davisjp1822/Quince_2560i/README.md

# Quince_2560i
Digital Input Protection Board with Ethernet for the Arduino Mega 2560

More information (and board available for purchase) at [https://www.three-ml.com](https://www.three-ml.com)
