davisjp1822/Quince_2560i/arduino-mega-io-protection.kicad_pcb

## KiCad design arduino-mega-io-protection.kicad_pcb (2017-09-17)

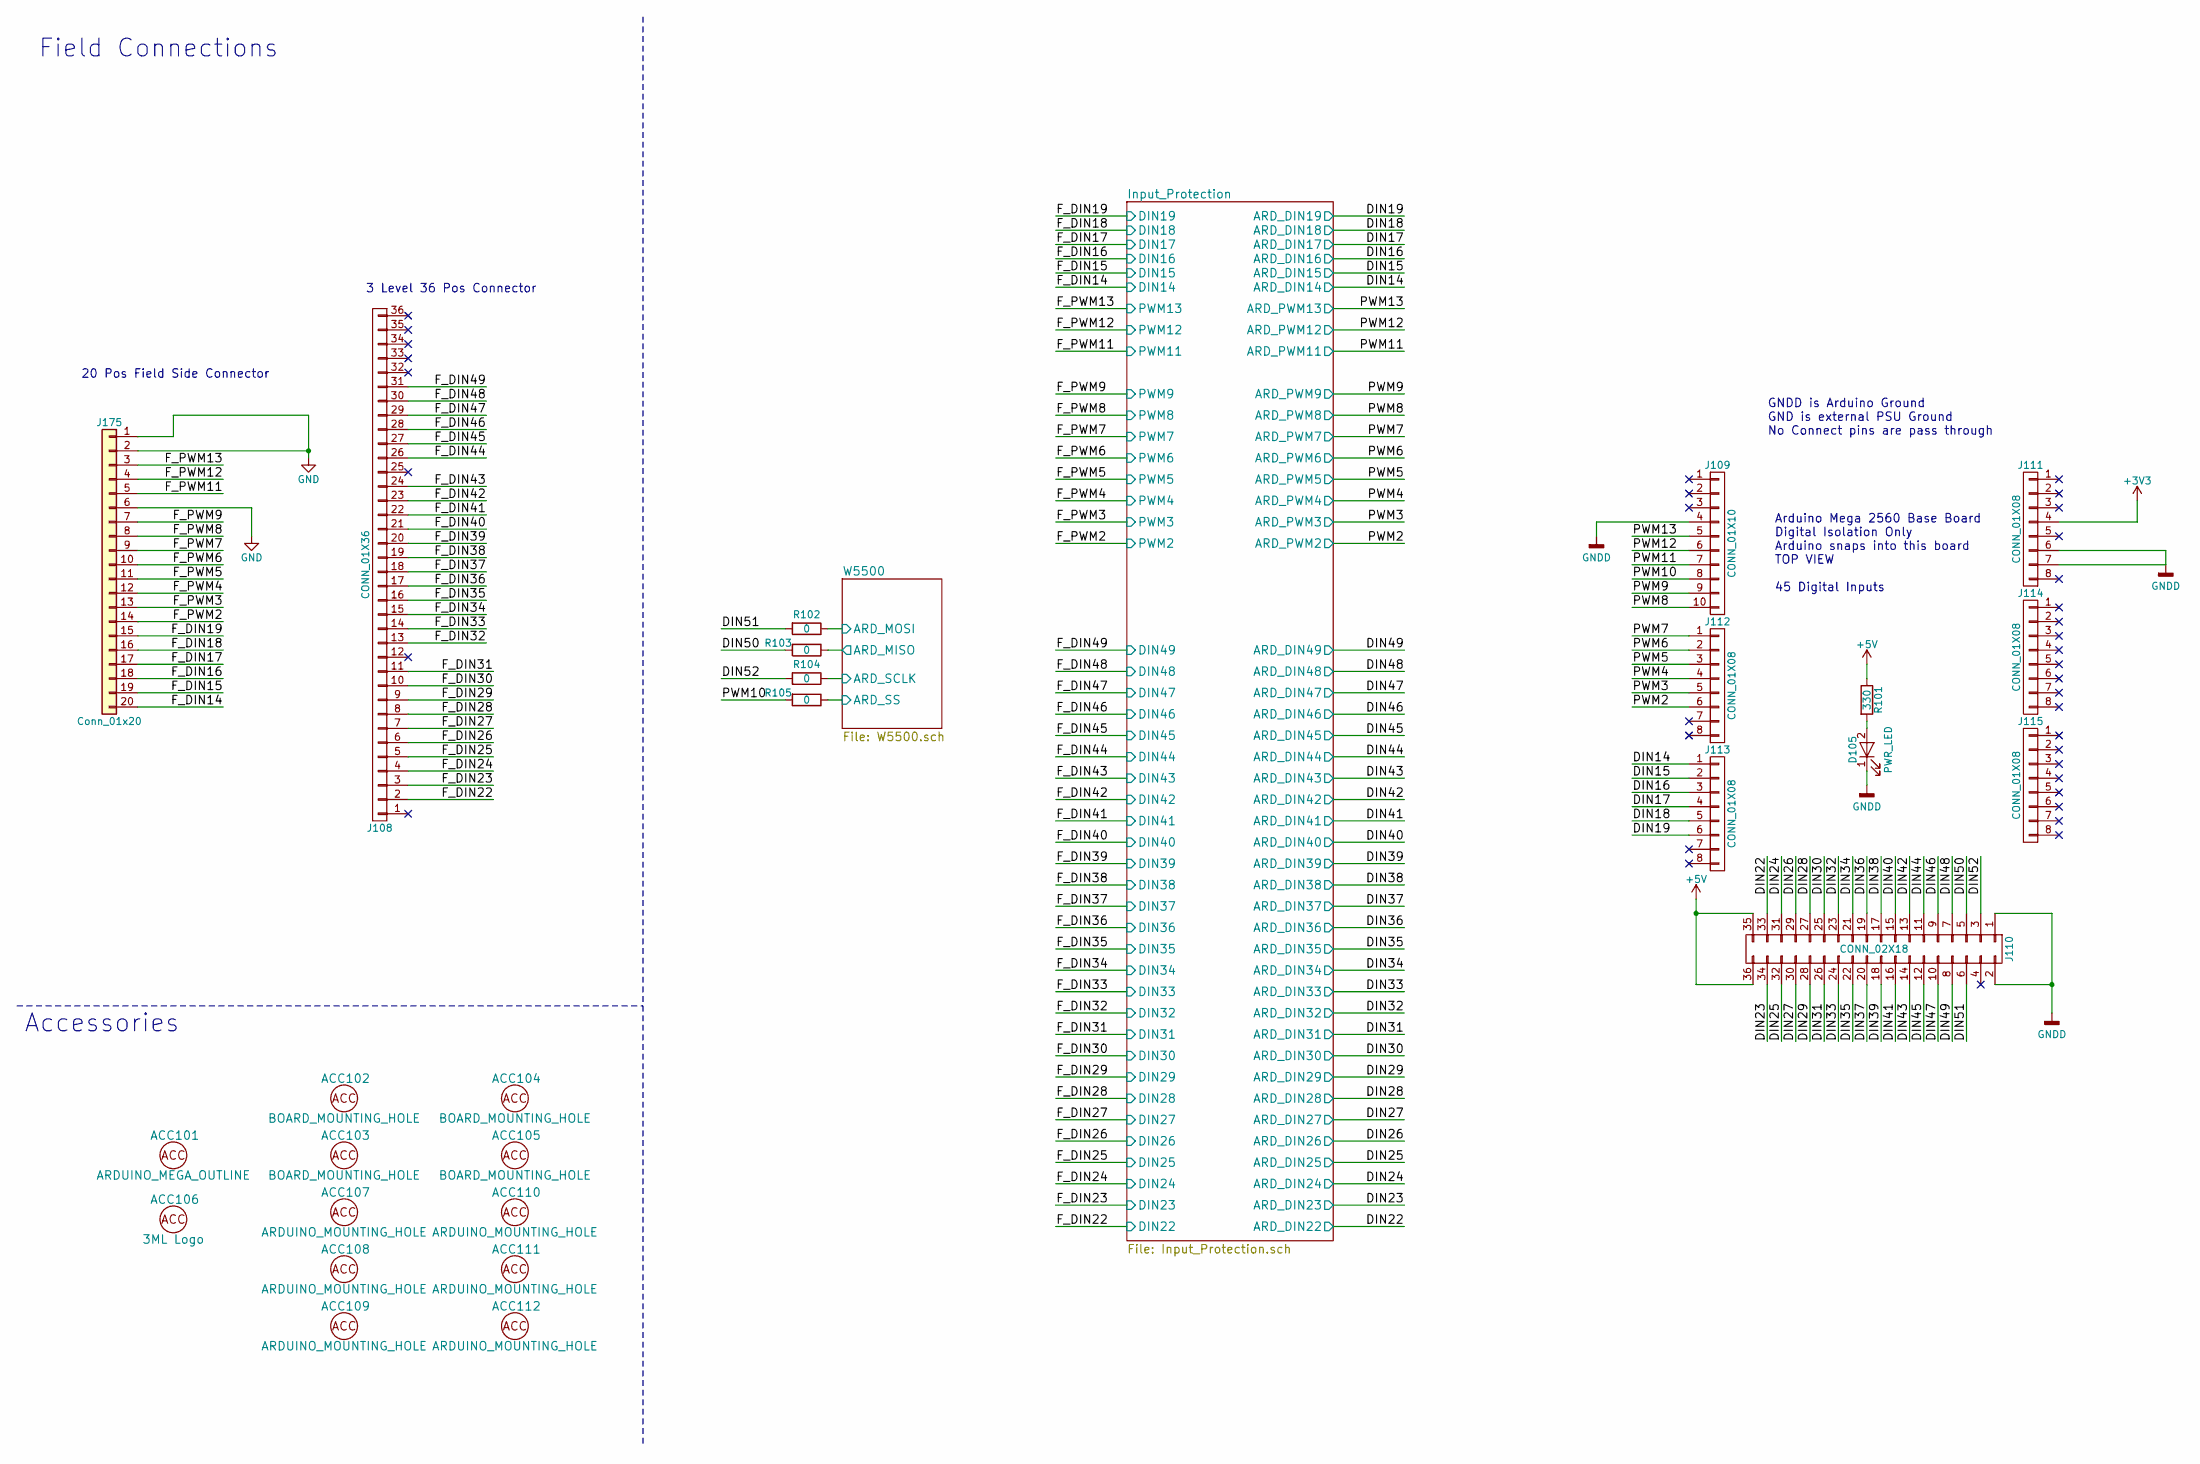
[picture p1: schematic arduino-mega-io-protection.sch, Quince 2560i Input Module with Ethernet]

Parts:
ACC101: ARDUINO_MEGA_OUTLINE; Arduino_Mega_2560__UPSIDE_DOWN_Footprint; MPN Value
ACC102, ACC103, ACC104, ACC105: BOARD_MOUNTING_HOLE; MountingHole_3.2mm_M3; MPN Value
ACC106: 3ML Logo; 3ML_LOGO; MPN X
ACC107, ACC108, ACC109, ACC110, ACC111, ACC112: ARDUINO_MOUNTING_HOLE; MountingHole_3.2mm_M3; MPN Value
D105: PWR_LED; LED_1206; MPN PG1101W-TR
J108: CONN_01X36; Phoenix_1727832; MPN 1727832
J109: CONN_01X10; Pin_Header_Straight_1x10_Pitch2.54mm; MPN X
J110: CONN_02X18; Pin_Header_Straight_2x18_Pitch2.54mm; MPN X
J111, J112, J113, J114, J115: CONN_01X08; Pin_Header_Straight_1x08_Pitch2.54mm; MPN X
J175: Conn_01x20; Phoenix-1x20-1709678
R101: 330; R_0805; MPN ERJ-P06J331V
R102, R103, R104, R105: 0; R_0805; MPN RC0805JR-070RL

Connections:
+3V3: J111.4; also elsewhere on the board
+5V: J110.35, J110.36, R101.1; also elsewhere on the board
/DIN14: J113.1; also elsewhere on the board
/DIN15: J113.2; also elsewhere on the board
/DIN16: J113.3; also elsewhere on the board
/DIN17: J113.4; also elsewhere on the board
/DIN18: J113.5; also elsewhere on the board
/DIN19: J113.6; also elsewhere on the board
/DIN22: J110.33; also elsewhere on the board
/DIN23: J110.34; also elsewhere on the board
/DIN24: J110.31; also elsewhere on the board
/DIN25: J110.32; also elsewhere on the board
/DIN26: J110.29; also elsewhere on the board
/DIN27: J110.30; also elsewhere on the board
/DIN28: J110.27; also elsewhere on the board
/DIN29: J110.28; also elsewhere on the board
/DIN30: J110.25; also elsewhere on the board
/DIN31: J110.26; also elsewhere on the board
/DIN32: J110.23; also elsewhere on the board
/DIN33: J110.24; also elsewhere on the board
/DIN34: J110.21; also elsewhere on the board
/DIN35: J110.22; also elsewhere on the board
/DIN36: J110.19; also elsewhere on the board
/DIN37: J110.20; also elsewhere on the board
/DIN38: J110.17; also elsewhere on the board
/DIN39: J110.18; also elsewhere on the board
/DIN40: J110.15; also elsewhere on the board
/DIN41: J110.16; also elsewhere on the board
/DIN42: J110.13; also elsewhere on the board
/DIN43: J110.14; also elsewhere on the board
/DIN44: J110.11; also elsewhere on the board
/DIN45: J110.12; also elsewhere on the board
/DIN46: J110.9; also elsewhere on the board
/DIN47: J110.10; also elsewhere on the board
/DIN48: J110.7; also elsewhere on the board
/DIN49: J110.8; also elsewhere on the board
/DIN50: J110.5, R103.2
/DIN51: J110.6, R102.2
/DIN52: J110.3, R104.2
/F_DIN14: J175.20; also elsewhere on the board
/F_DIN15: J175.19; also elsewhere on the board
/F_DIN16: J175.18; also elsewhere on the board
/F_DIN17: J175.17; also elsewhere on the board
/F_DIN18: J175.16; also elsewhere on the board
/F_DIN19: J175.15; also elsewhere on the board
/F_DIN22: J108.2; also elsewhere on the board
/F_DIN23: J108.3; also elsewhere on the board
/F_DIN24: J108.4; also elsewhere on the board
/F_DIN25: J108.5; also elsewhere on the board
/F_DIN26: J108.6; also elsewhere on the board
/F_DIN27: J108.7; also elsewhere on the board
/F_DIN28: J108.8; also elsewhere on the board
/F_DIN29: J108.9; also elsewhere on the board
/F_DIN30: J108.10; also elsewhere on the board
/F_DIN31: J108.11; also elsewhere on the board
/F_DIN32: J108.13; also elsewhere on the board
/F_DIN33: J108.14; also elsewhere on the board
/F_DIN34: J108.15; also elsewhere on the board
/F_DIN35: J108.16; also elsewhere on the board
/F_DIN36: J108.17; also elsewhere on the board
/F_DIN37: J108.18; also elsewhere on the board
/F_DIN38: J108.19; also elsewhere on the board
/F_DIN39: J108.20; also elsewhere on the board
/F_DIN40: J108.21; also elsewhere on the board
/F_DIN41: J108.22; also elsewhere on the board
/F_DIN42: J108.23; also elsewhere on the board
/F_DIN43: J108.24; also elsewhere on the board
/F_DIN44: J108.26; also elsewhere on the board
/F_DIN45: J108.27; also elsewhere on the board
/F_DIN46: J108.28; also elsewhere on the board
/F_DIN47: J108.29; also elsewhere on the board
/F_DIN48: J108.30; also elsewhere on the board
/F_DIN49: J108.31; also elsewhere on the board
/F_PWM2: J175.14; also elsewhere on the board
/F_PWM3: J175.13; also elsewhere on the board
/F_PWM4: J175.12; also elsewhere on the board
/F_PWM5: J175.11; also elsewhere on the board
/F_PWM6: J175.10; also elsewhere on the board
/F_PWM7: J175.9; also elsewhere on the board
/F_PWM8: J175.8; also elsewhere on the board
/F_PWM9: J175.7; also elsewhere on the board
/F_PWM11: J175.5; also elsewhere on the board
/F_PWM12: J175.4; also elsewhere on the board
/F_PWM13: J175.3; also elsewhere on the board
/PWM2: J112.6; also elsewhere on the board
/PWM3: J112.5; also elsewhere on the board
/PWM4: J112.4; also elsewhere on the board
/PWM5: J112.3; also elsewhere on the board
/PWM6: J112.2; also elsewhere on the board
/PWM7: J112.1; also elsewhere on the board
/PWM8: J109.10; also elsewhere on the board
/PWM9: J109.9; also elsewhere on the board
/PWM10: J109.8, R105.2
/PWM11: J109.7; also elsewhere on the board
/PWM12: J109.6; also elsewhere on the board
/PWM13: J109.5; also elsewhere on the board
/W5500/ARD_MISO: R103.1; also elsewhere on the board
/W5500/ARD_MOSI: R102.1; also elsewhere on the board
/W5500/ARD_SCLK: R104.1; also elsewhere on the board
/W5500/ARD_SS: R105.1; also elsewhere on the board
GND: J175.1, J175.2, J175.6; also elsewhere on the board
GNDD: D105.1 (K), J109.4, J110.1, J110.2, J111.6, J111.7; also elsewhere on the board
unnamed: D105.2 (A), R101.2

Notes on the sheet:
GNDD is Arduino Ground GND is external PSU Ground No Connect pins are pass through
Arduino Mega 2560 Base Board Digital Isolation Only Arduino snaps into this board TOP VIEW 45 Digital Inputs
3 Level 36 Pos Connector
20 Pos Field Side Connector
Accessories
Field Connections

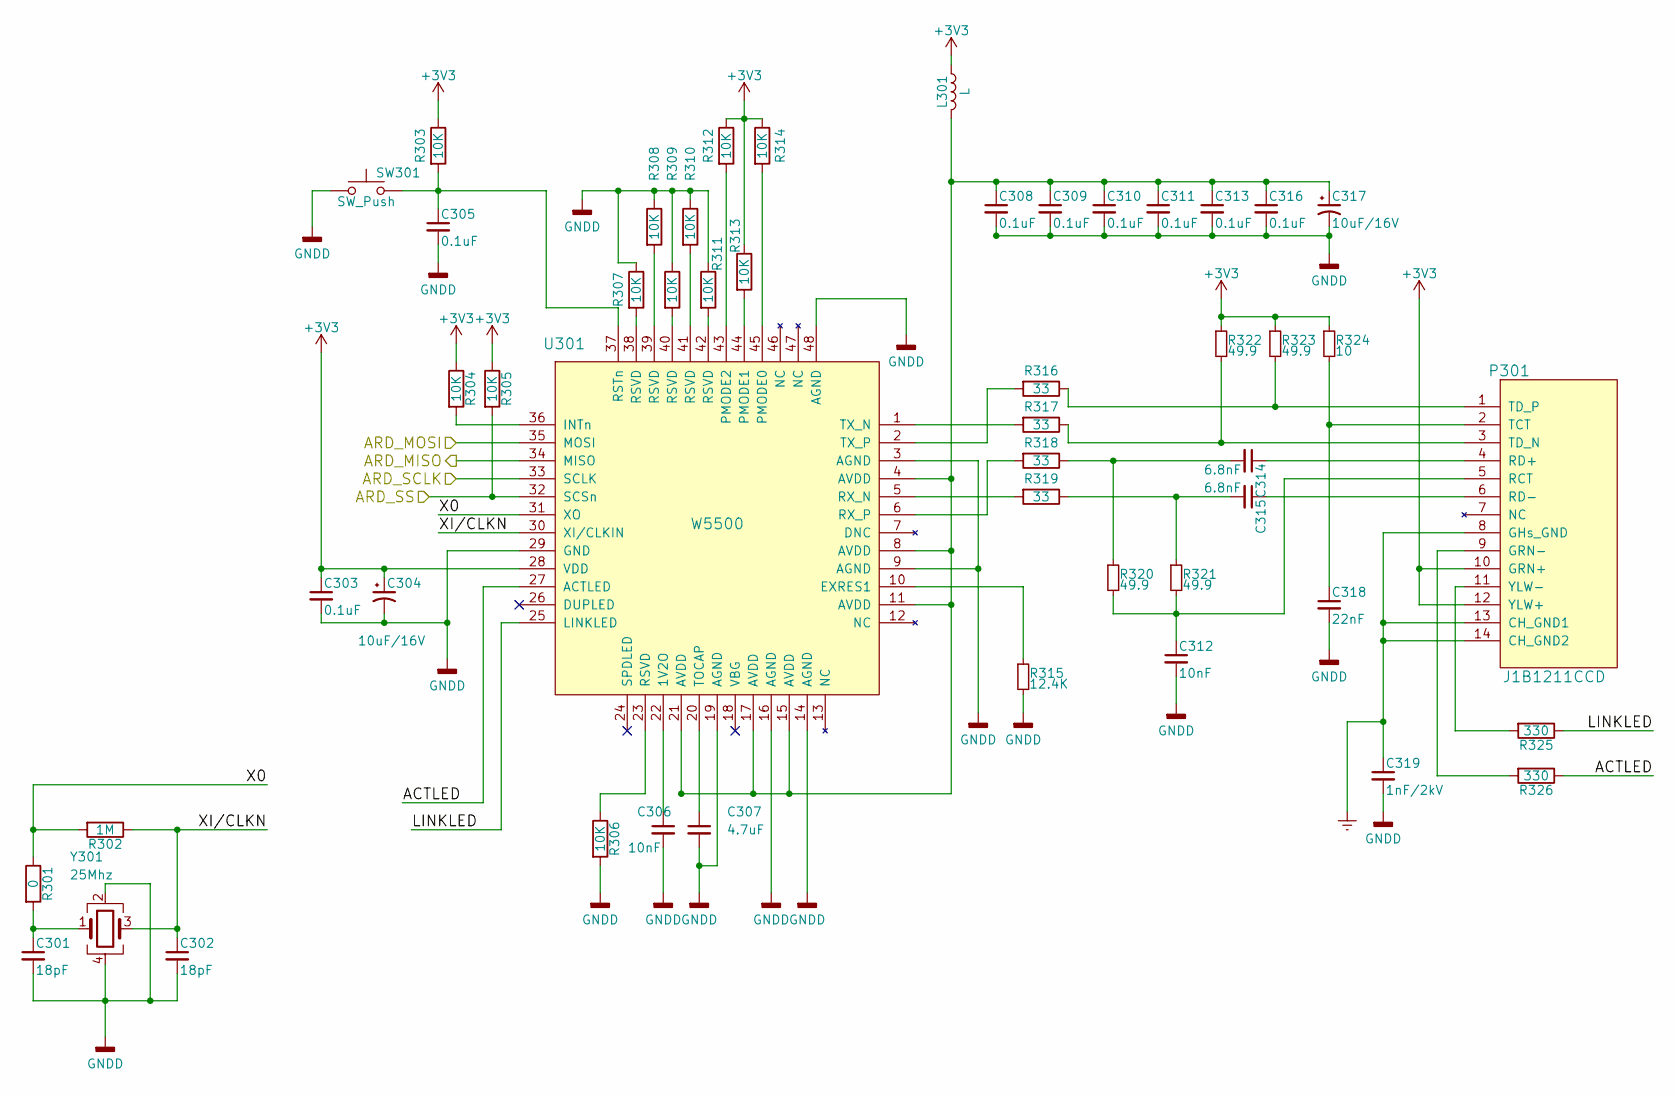
[picture p2: schematic W5500.sch, Quince 2560i W5500 Ethernet]

Parts:
C301, C302: 18pF; C_0603; MPN GRM1885C1H180FA01D
C303, C305, C308, C309, C310, C311, C313, C316: 0.1uF; C_0805; MPN 08055C104KAT2A
C304, C317: 10uF/16V; CP_Tantalum_Case-A_EIA-3216-18_Reflow; MPN F931C106MAA
C306, C312: 10nF; C_0805; MPN CC0805KRX7R9BB103
C307: 4.7uF; C_0805; MPN GRM21BR71C475KE51L
C314, C315: 6.8nF; C_0805; MPN CC0805KRX7R9BB682
C318: 22nF; C_0805; MPN C0805C223K5RACTU
C319: 1nF/2kV; C_1206; MPN 202R18W102KV4E
L301: L; R_1812; MPN 742792511
P301: J1B1211CCD; MPN J1B1211CCD
R301: 0; R_0805; MPN RC0805JR-070RL
R302: 1M; R_0805; MPN RC0805FR-071ML
R303, R304, R305, R306, R307, R308, R309, R310, R311, R312, R313, R314: 10K; R_0805; MPN RC0805JR-0710KL
R315: 12.4K; R_0805; MPN RC0805FR-0712K4L
R316, R317, R318, R319: 33; R_0805; MPN RC0805FR-0733RL
R320, R321, R322, R323: 49.9; R_0805; MPN RC0805FR-0749R9L
R324: 10; R_0805; MPN RC0805FR-0710RL
R325, R326: 330; R_0805; MPN RMCF0805JT330R
SW301: SW_Push; SW_SPST_PTS645; MPN PTS645SK43SMTR92 LFS
U301: W5500; LQFP-48_7x7mm_Pitch0.5mm; MPN W5500
Y301: 25Mhz; Oscillator_SMD_Abracon_ASE-4pin_3.2x2.5mm; MPN ABM8G-25.000MHZ-18-D2Y-T

Connections:
+3V3: C303.1, C304.1, L301.1, P301.10 (GRN+), P301.12 (YLW+), R303.1, R304.1, R305.1, R312.1, R313.1, R314.1, R322.1, R323.1, R324.1, U301.28 (VDD); also elsewhere on the board
/W5500/ACTLED: R326.1, U301.27 (ACTLED)
/W5500/ARD_MISO: U301.34 (MISO); also elsewhere on the board
/W5500/ARD_MOSI: U301.35 (MOSI); also elsewhere on the board
/W5500/ARD_SCLK: U301.33 (SCLK); also elsewhere on the board
/W5500/ARD_SS: R305.2, U301.32 (SCSn); also elsewhere on the board
/W5500/LINKLED: R325.1, U301.25 (LINKLED)
/W5500/X0: R301.1, R302.2, U301.31 (XO)
/W5500/XI/CLKN: C302.1, R302.1, U301.30 (XI/CLKIN), Y301.3
Earth: C319.1, P301.8 (GHs_GND), P301.13 (CH_GND1), P301.14 (CH_GND2)
GNDD: C301.2, C302.2, C303.2, C304.2, C305.2, C306.2, C307.2, C308.2, C309.2, C310.2, C311.2, C312.2, C313.2, C316.2, C317.2, C318.2, C319.2, R306.2, R307.1, R308.1, R309.1, R310.1, R311.1, R315.2, SW301.1, U301.3 (AGND), U301.9 (AGND), U301.14 (AGND), U301.16 (AGND), U301.19 (AGND), U301.29 (GND), U301.48 (AGND), Y301.2, Y301.4; also elsewhere on the board
unnamed: C301.1, R301.2, Y301.1
unnamed: C305.1, R303.2, SW301.2, U301.37 (RSTn)
unnamed: C306.1, U301.22 (1V2O)
unnamed: C307.1, U301.20 (TOCAP)
unnamed: C308.1, C309.1, C310.1, C311.1, C313.1, C316.1, C317.1, L301.2, U301.4 (AVDD), U301.8 (AVDD), U301.11 (AVDD), U301.15 (AVDD), U301.17 (AVDD), U301.21 (AVDD)
unnamed: C312.1, P301.5 (RCT), R320.2, R321.2
unnamed: C314.1, P301.4 (RD+)
unnamed: C314.2, R318.1, R320.1
unnamed: C315.1, P301.6 (RD-)
unnamed: C315.2, R319.1, R321.1
unnamed: C318.1, P301.2 (TCT), R324.2
unnamed: P301.1 (TD_P), R316.1, R323.2
unnamed: P301.3 (TD_N), R317.1, R322.2
unnamed: P301.9 (GRN-), R326.2
unnamed: P301.11 (YLW-), R325.2
unnamed: R304.2, U301.36 (INTn)
unnamed: R306.1, U301.23 (RSVD)
unnamed: R307.2, U301.38 (RSVD)
unnamed: R308.2, U301.39 (RSVD)
unnamed: R309.2, U301.40 (RSVD)
unnamed: R310.2, U301.41 (RSVD)
unnamed: R311.2, U301.42 (RSVD)
unnamed: R312.2, U301.43 (PMODE2)
unnamed: R313.2, U301.44 (PMODE1)
unnamed: R314.2, U301.45 (PMODE0)
unnamed: R315.1, U301.10 (EXRES1)
unnamed: R316.2, U301.2 (TX_P)
unnamed: R317.2, U301.1 (TX_N)
unnamed: R318.2, U301.6 (RX_P)
unnamed: R319.2, U301.5 (RX_N)

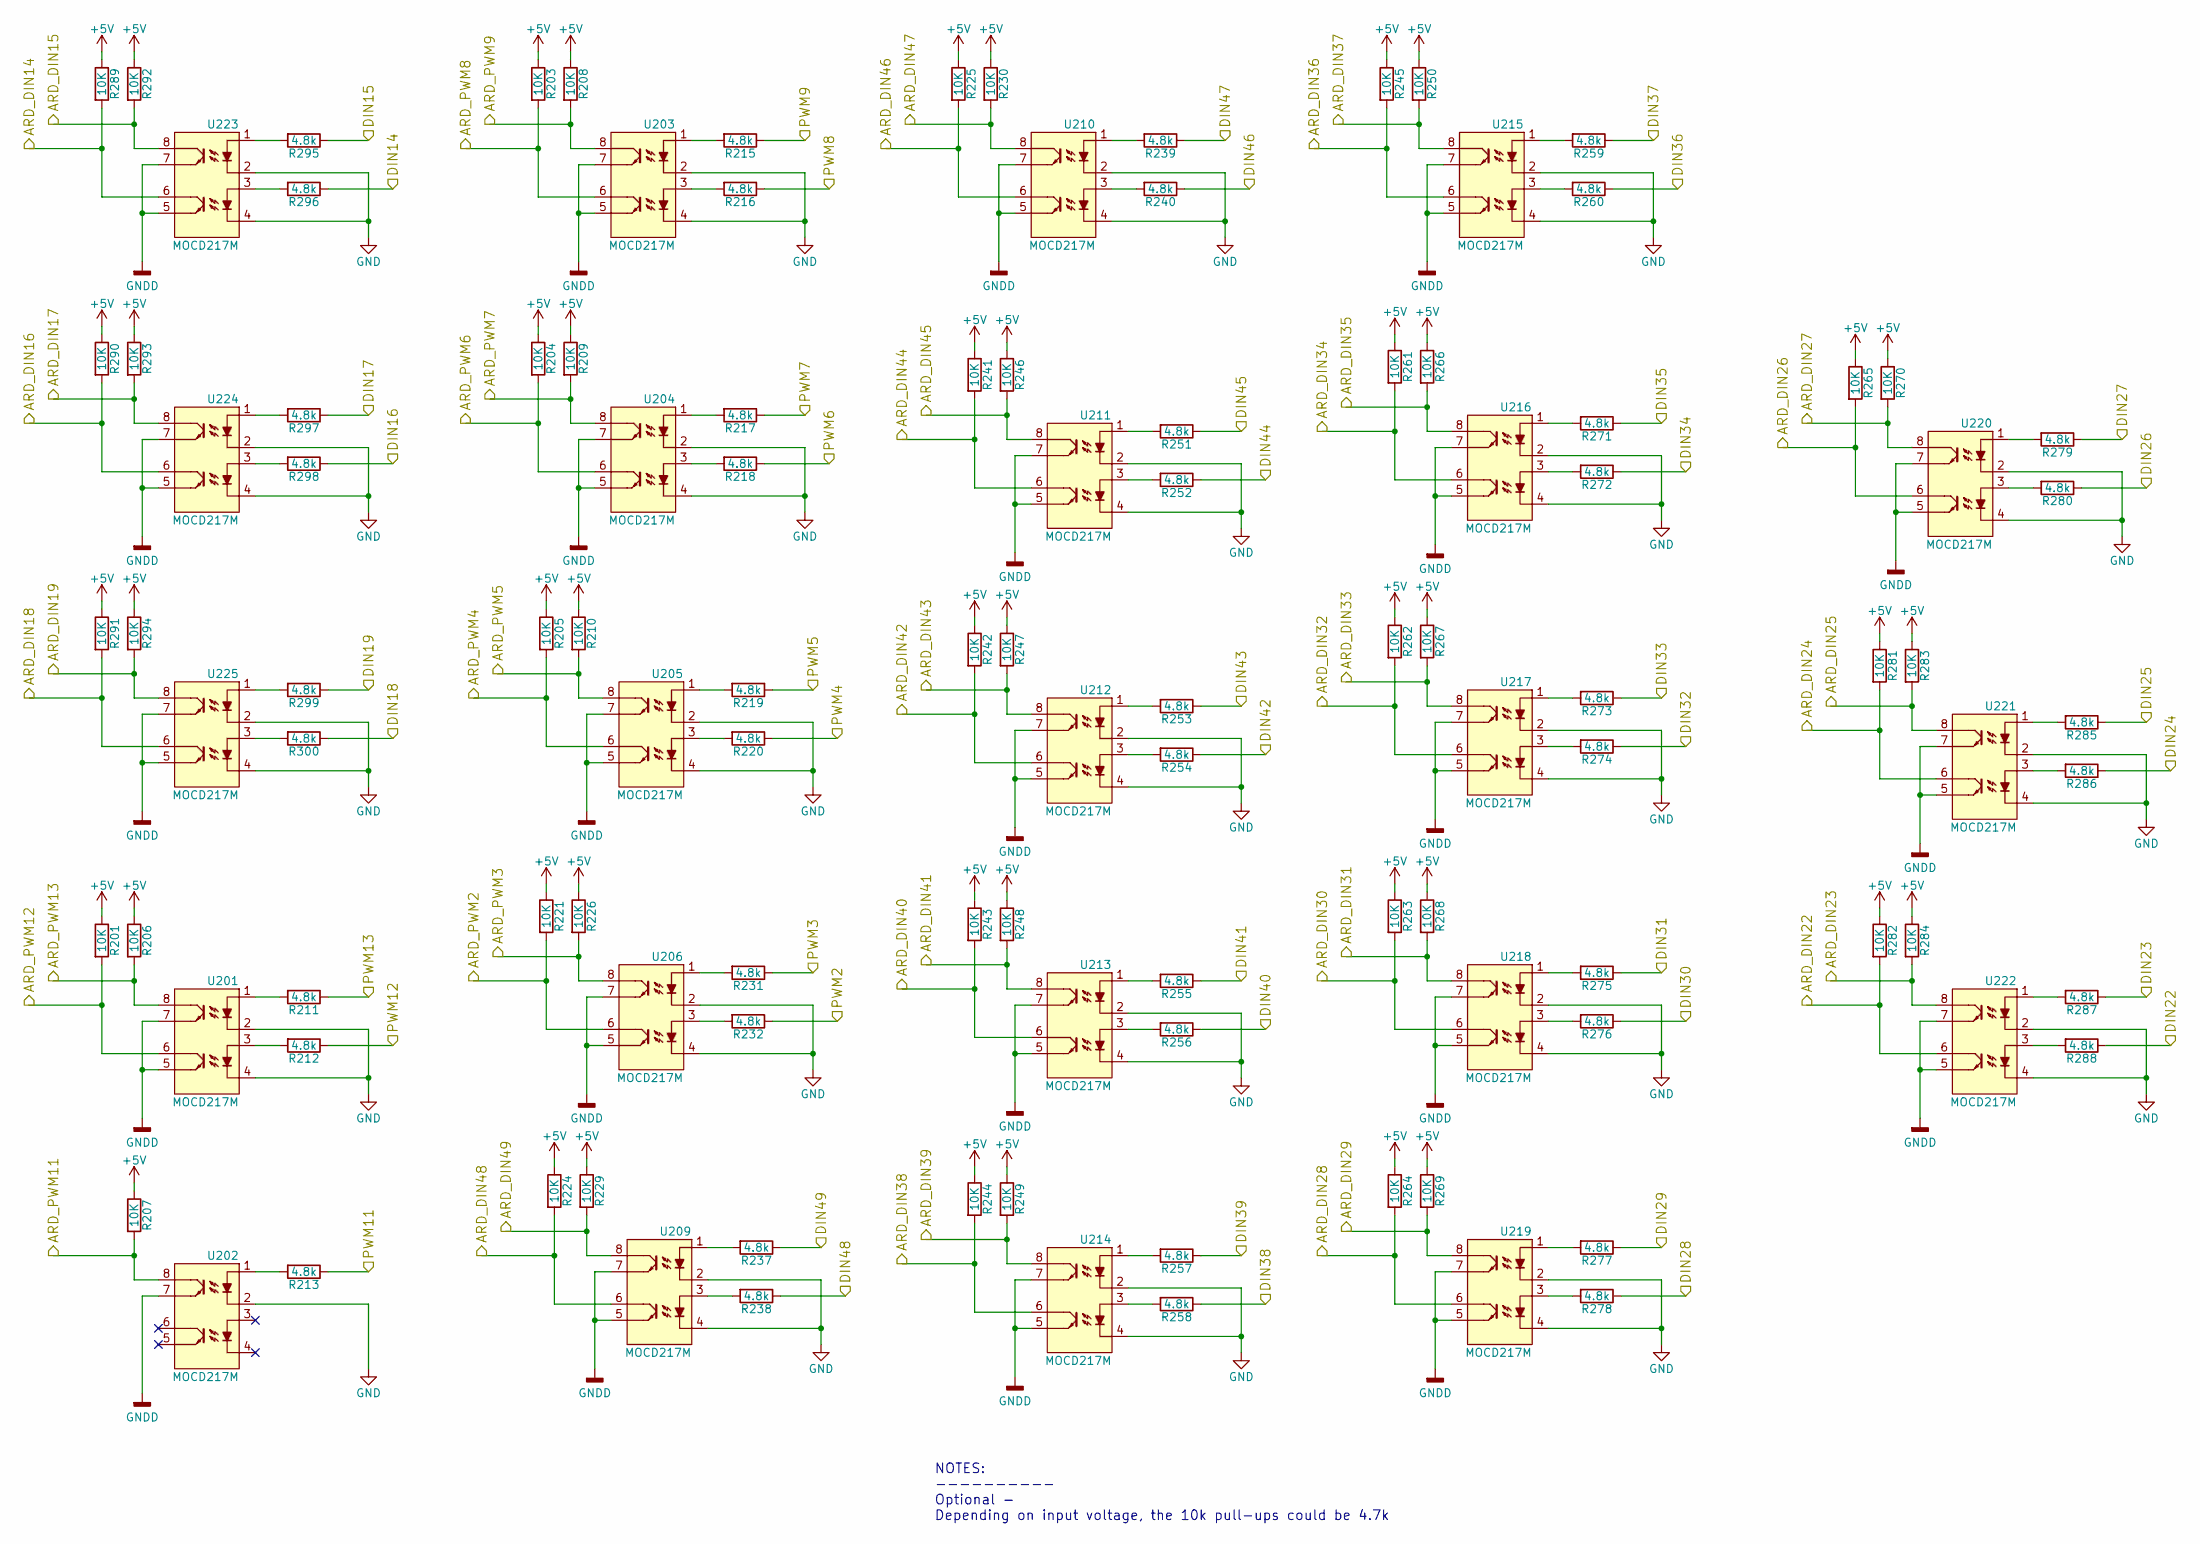
[picture p3: schematic Input_Protection.sch, Quince 2560i Inputs]

Parts:
R201, R203, R204, R205, R206, R207, R208, R209, R210, R221, R224, R225, R226, R229, R230, R241, R242, R243, R244, R245, R246, R247, R248, R249, R250, R261, R262, R263, R264, R265, R266, R267, R268, R269, R270, R281, R282, R283, R284, R289, R290, R291, R292, R293, R294: 10K; R_0805; MPN RC0805JR-0710KL
R211, R212, R213, R215, R216, R217, R218, R219, R220, R231, R232, R237, R238, R239, R240, R251, R252, R253, R254, R255, R256, R257, R258, R259, R260, R271, R272, R273, R274, R275, R276, R277, R278, R279, R280, R285, R286, R287, R288, R295, R296, R297, R298, R299, R300: 4.8k; R_1206; MPN RNCP1206FTD4K75
U201, U202, U203, U204, U205, U206, U209, U210, U211, U212, U213, U214, U215, U216, U217, U218, U219, U220, U221, U222, U223, U224, U225: MOCD217M; SOIC-8_3.9x4.9mm_Pitch1.27mm; MPN MOCD217M

Connections:
+5V: R201.1, R203.1, R204.1, R205.1, R206.1, R207.1, R208.1, R209.1, R210.1, R221.1, R224.1, R225.1, R226.1, R229.1, R230.1, R241.1, R242.1, R243.1, R244.1, R245.1, R246.1, R247.1, R248.1, R249.1, R250.1, R261.1, R262.1, R263.1, R264.1, R265.1, R266.1, R267.1, R268.1, R269.1, R270.1, R281.1, R282.1, R283.1, R284.1, R289.1, R290.1, R291.1, R292.1, R293.1, R294.1; also elsewhere on the board
/DIN14: R289.2, U223.6; also elsewhere on the board
/DIN15: R292.2, U223.8; also elsewhere on the board
/DIN16: R290.2, U224.6; also elsewhere on the board
/DIN17: R293.2, U224.8; also elsewhere on the board
/DIN18: R291.2, U225.6; also elsewhere on the board
/DIN19: R294.2, U225.8; also elsewhere on the board
/DIN22: R282.2, U222.6; also elsewhere on the board
/DIN23: R284.2, U222.8; also elsewhere on the board
/DIN24: R281.2, U221.6; also elsewhere on the board
/DIN25: R283.2, U221.8; also elsewhere on the board
/DIN26: R265.2, U220.6; also elsewhere on the board
/DIN27: R270.2, U220.8; also elsewhere on the board
/DIN28: R264.2, U219.6; also elsewhere on the board
/DIN29: R269.2, U219.8; also elsewhere on the board
/DIN30: R263.2, U218.6; also elsewhere on the board
/DIN31: R268.2, U218.8; also elsewhere on the board
/DIN32: R262.2, U217.6; also elsewhere on the board
/DIN33: R267.2, U217.8; also elsewhere on the board
/DIN34: R261.2, U216.6; also elsewhere on the board
/DIN35: R266.2, U216.8; also elsewhere on the board
/DIN36: R245.2, U215.6; also elsewhere on the board
/DIN37: R250.2, U215.8; also elsewhere on the board
/DIN38: R244.2, U214.6; also elsewhere on the board
/DIN39: R249.2, U214.8; also elsewhere on the board
/DIN40: R243.2, U213.6; also elsewhere on the board
/DIN41: R248.2, U213.8; also elsewhere on the board
/DIN42: R242.2, U212.6; also elsewhere on the board
/DIN43: R247.2, U212.8; also elsewhere on the board
/DIN44: R241.2, U211.6; also elsewhere on the board
/DIN45: R246.2, U211.8; also elsewhere on the board
/DIN46: R225.2, U210.6; also elsewhere on the board
/DIN47: R230.2, U210.8; also elsewhere on the board
/DIN48: R224.2, U209.6; also elsewhere on the board
/DIN49: R229.2, U209.8; also elsewhere on the board
/F_DIN14: R296.1; also elsewhere on the board
/F_DIN15: R295.1; also elsewhere on the board
/F_DIN16: R298.1; also elsewhere on the board
/F_DIN17: R297.1; also elsewhere on the board
/F_DIN18: R300.1; also elsewhere on the board
/F_DIN19: R299.1; also elsewhere on the board
/F_DIN22: R288.1; also elsewhere on the board
/F_DIN23: R287.1; also elsewhere on the board
/F_DIN24: R286.1; also elsewhere on the board
/F_DIN25: R285.1; also elsewhere on the board
/F_DIN26: R280.1; also elsewhere on the board
/F_DIN27: R279.1; also elsewhere on the board
/F_DIN28: R278.1; also elsewhere on the board
/F_DIN29: R277.1; also elsewhere on the board
/F_DIN30: R276.1; also elsewhere on the board
/F_DIN31: R275.1; also elsewhere on the board
/F_DIN32: R274.1; also elsewhere on the board
/F_DIN33: R273.1; also elsewhere on the board
/F_DIN34: R272.1; also elsewhere on the board
/F_DIN35: R271.1; also elsewhere on the board
/F_DIN36: R260.1; also elsewhere on the board
/F_DIN37: R259.1; also elsewhere on the board
/F_DIN38: R258.1; also elsewhere on the board
/F_DIN39: R257.1; also elsewhere on the board
/F_DIN40: R256.1; also elsewhere on the board
/F_DIN41: R255.1; also elsewhere on the board
/F_DIN42: R254.1; also elsewhere on the board
/F_DIN43: R253.1; also elsewhere on the board
/F_DIN44: R252.1; also elsewhere on the board
/F_DIN45: R251.1; also elsewhere on the board
/F_DIN46: R240.1; also elsewhere on the board
/F_DIN47: R239.1; also elsewhere on the board
/F_DIN48: R238.1; also elsewhere on the board
/F_DIN49: R237.1; also elsewhere on the board
/F_PWM2: R232.1; also elsewhere on the board
/F_PWM3: R231.1; also elsewhere on the board
/F_PWM4: R220.1; also elsewhere on the board
/F_PWM5: R219.1; also elsewhere on the board
/F_PWM6: R218.1; also elsewhere on the board
/F_PWM7: R217.1; also elsewhere on the board
/F_PWM8: R216.1; also elsewhere on the board
/F_PWM9: R215.1; also elsewhere on the board
/F_PWM11: R213.1; also elsewhere on the board
/F_PWM12: R212.1; also elsewhere on the board
/F_PWM13: R211.1; also elsewhere on the board
/PWM2: R221.2, U206.6; also elsewhere on the board
/PWM3: R226.2, U206.8; also elsewhere on the board
/PWM4: R205.2, U205.6; also elsewhere on the board
/PWM5: R210.2, U205.8; also elsewhere on the board
/PWM6: R204.2, U204.6; also elsewhere on the board
/PWM7: R209.2, U204.8; also elsewhere on the board
/PWM8: R203.2, U203.6; also elsewhere on the board
/PWM9: R208.2, U203.8; also elsewhere on the board
/PWM11: R207.2, U202.8; also elsewhere on the board
/PWM12: R201.2, U201.6; also elsewhere on the board
/PWM13: R206.2, U201.8; also elsewhere on the board
GND: U201.2, U201.4, U202.2, U203.2, U203.4, U204.2, U204.4, U205.2, U205.4, U206.2, U206.4, U209.2, U209.4, U210.2, U210.4, U211.2, U211.4, U212.2, U212.4, U213.2, U213.4, U214.2, U214.4, U215.2, U215.4, U216.2, U216.4, U217.2, U217.4, U218.2, U218.4, U219.2, U219.4, U220.2, U220.4, U221.2, U221.4, U222.2, U222.4, U223.2, U223.4, U224.2, U224.4, U225.2, U225.4; also elsewhere on the board
GNDD: U201.5, U201.7, U202.7, U203.5, U203.7, U204.5, U204.7, U205.5, U205.7, U206.5, U206.7, U209.5, U209.7, U210.5, U210.7, U211.5, U211.7, U212.5, U212.7, U213.5, U213.7, U214.5, U214.7, U215.5, U215.7, U216.5, U216.7, U217.5, U217.7, U218.5, U218.7, U219.5, U219.7, U220.5, U220.7, U221.5, U221.7, U222.5, U222.7, U223.5, U223.7, U224.5, U224.7, U225.5, U225.7; also elsewhere on the board
unnamed: R211.2, U201.1
unnamed: R212.2, U201.3
unnamed: R213.2, U202.1
unnamed: R215.2, U203.1
unnamed: R216.2, U203.3
unnamed: R217.2, U204.1
unnamed: R218.2, U204.3
unnamed: R219.2, U205.1
unnamed: R220.2, U205.3
unnamed: R231.2, U206.1
unnamed: R232.2, U206.3
unnamed: R237.2, U209.1
unnamed: R238.2, U209.3
unnamed: R239.2, U210.1
unnamed: R240.2, U210.3
unnamed: R251.2, U211.1
unnamed: R252.2, U211.3
unnamed: R253.2, U212.1
unnamed: R254.2, U212.3
unnamed: R255.2, U213.1
unnamed: R256.2, U213.3
unnamed: R257.2, U214.1
unnamed: R258.2, U214.3
unnamed: R259.2, U215.1
unnamed: R260.2, U215.3
unnamed: R271.2, U216.1
unnamed: R272.2, U216.3
unnamed: R273.2, U217.1
unnamed: R274.2, U217.3
unnamed: R275.2, U218.1
unnamed: R276.2, U218.3
unnamed: R277.2, U219.1
unnamed: R278.2, U219.3
unnamed: R279.2, U220.1
unnamed: R280.2, U220.3
unnamed: R285.2, U221.1
unnamed: R286.2, U221.3
unnamed: R287.2, U222.1
unnamed: R288.2, U222.3
unnamed: R295.2, U223.1
unnamed: R296.2, U223.3
unnamed: R297.2, U224.1
unnamed: R298.2, U224.3
unnamed: R299.2, U225.1
unnamed: R300.2, U225.3

Notes on the sheet:
NOTES: ---------- Optional - Depending on input voltage, the 10k pull-ups could be 4.7k

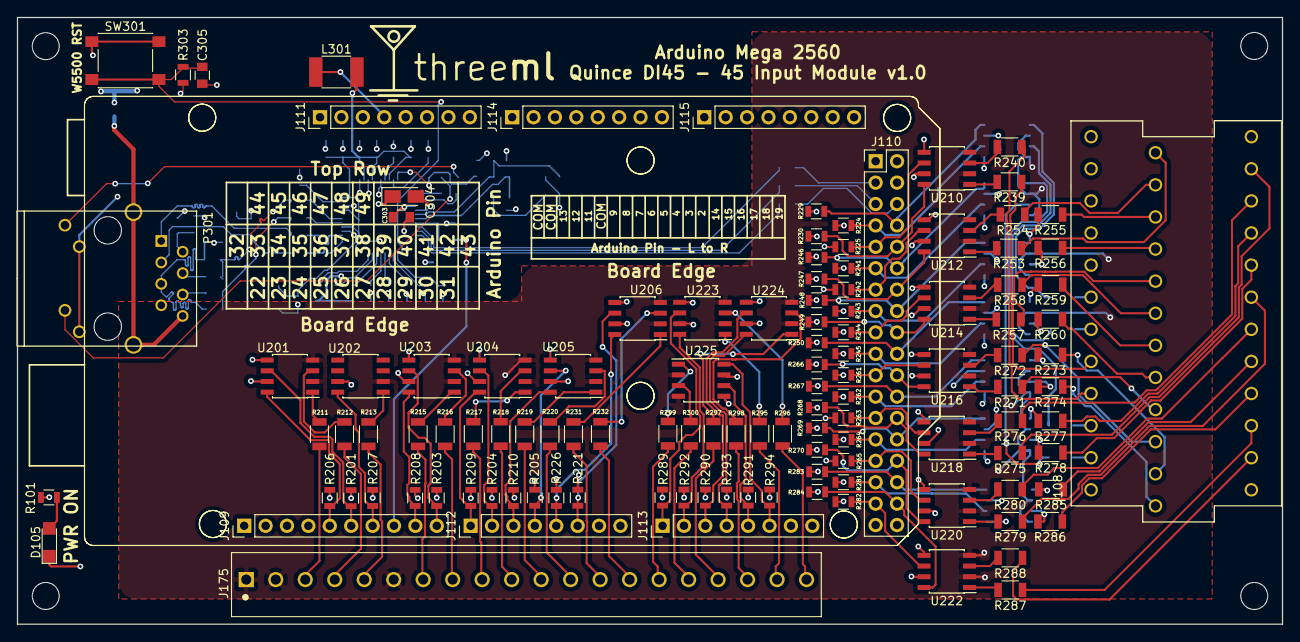
[picture p4: board arduino-mega-io-protection.kicad_pcb from above]

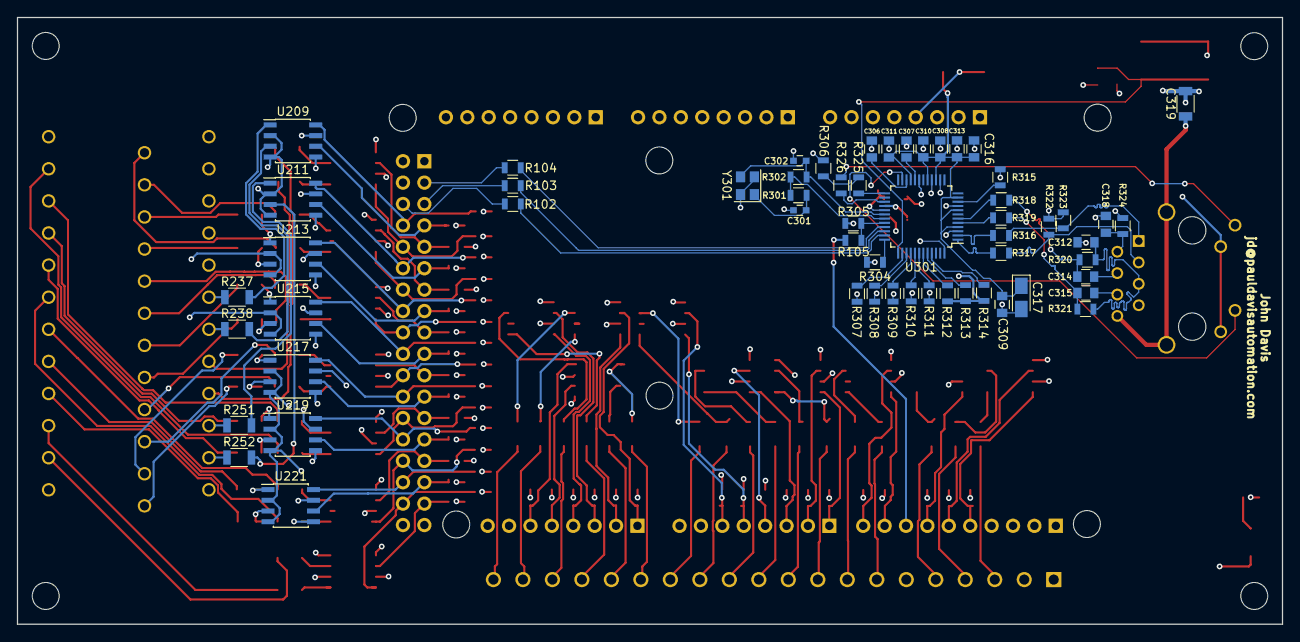
[picture p5: board arduino-mega-io-protection.kicad_pcb from below]

Board: 4 copper layers, 150.1 x 72.0 mm, 191 parts (58 on the bottom side), 183 nets.

Other parts of the board:
ACC101#2: ARDUINO_MEGA_OUTLINE; Arduino_Mega_2560__UPSIDE_DOWN_Footprint
