davisjp1822/Quince_2560i/(commit log)

2017-04-27 footprints cleaned-up and submitted to oshpark!
    [Input_Protection.sch, Phoenix-1727832.step, Sullins-PRPC008SAAN-RC.STEP, Wurth_691103110002.step, arduino-mega-io-protection.kicad_pcb, arduino-mega-io-protection.step, arduino_mega_io_protection.FCStd]
2017-05-10 inserting part information for connectors into BOM
    [Input_Protection.sch, arduino-mega-io-protection.sch]
2017-06-04 adding serial 1, 2, and 3 as protected inputs
    [Input_Protection.sch, arduino-mega-io-protection.kicad_pcb, arduino-mega-io-protection.sch]
2017-06-05 moving schematics around making room for ethernet stuff
    [arduino-mega-io-protection.sch]
2017-06-07 W5500 schematic complete and populated
    [Input_Protection.sch, W5500.sch, arduino-mega-io-protection.kicad_pcb, arduino-mega-io-protection.sch]
2017-06-07 connecting spi lines and cleaning-up I/O
    [Input_Protection.sch, W5500.sch, arduino-mega-io-protection.sch]
2017-06-08 more work on ethernet layout
    [arduino-mega-io-protection.kicad_pcb]
2017-06-12 more tweaks
    [W5500.sch, arduino-mega-io-protection.kicad_pcb, arduino-mega-io-protection.sch]
2017-06-16 almost final design - just need to add protection diodes
    [Input_Protection.sch, W5500.sch, arduino-mega-io-protection.kicad_pcb, arduino-mega-io-protection.sch]
2017-06-21 final design sent to fab
    [W5500.sch, arduino-mega-io-protection.kicad_pcb]
2017-07-13 fixing BOM for arduino connectors and updating some other items
    [Input_Protection.sch, W5500.sch, arduino-mega-io-protection.kicad_pcb, arduino-mega-io-protection.sch]
2017-08-07 getting ready to add master component library
    [Phoenix-1727832.step, Sullins-PRPC008SAAN-RC.STEP, Wurth_691103110002.step]
2017-08-09 adding global hardware library, also fixed some footprint issues and added reverse protection diodes. also cleaned-up design
    [Input_Protection.sch, W5500.sch, arduino-mega-io-protection.kicad_pcb, arduino-mega-io-protection.sch]
2017-08-12 updated for rev2 to go to OSHPark. Fixed footprints and changed topside routing to have better noise characteristics
    [Input_Protection.sch, W5500.sch, arduino-mega-io-protection.kicad_pcb, arduino-mega-io-protection.sch]
2017-08-12 updating solder mask to reflect product name - sent to OSHPark
    [arduino-mega-io-protection.kicad_pcb]
2017-08-25 fixing some component/BOM part numbers
    [W5500.sch, arduino-mega-io-protection.sch]
2017-09-13 moving diodes away from edge
    [arduino-mega-io-protection.kicad_pcb]
2017-09-16 fixing diode location
    [arduino-mega-io-protection.kicad_pcb]
2017-09-16 updating schematic to look more consistent
    [Input_Protection.sch, arduino-mega-io-protection.sch]
2017-09-16 updating schematic and library to use a Phoenix header for the 1x20
    [arduino-mega-io-protection.kicad_pcb, arduino-mega-io-protection.sch]
2017-09-16 fixing title block and page size
    [W5500.sch]
2017-09-17 removing unnecessary diodes
    [arduino-mega-io-protection.kicad_pcb, arduino-mega-io-protection.sch]
2017-09-17 fixing footprint issue with oscillator (missing paste)
    [arduino-mega-io-protection.kicad_pcb]
2018-06-11 adding arduino sample code
